Jonas-Gabriel/MercedesC219W211KinematicController/MercedesC219W211KinematicController_Images/ATTiny45-20 Layout.png

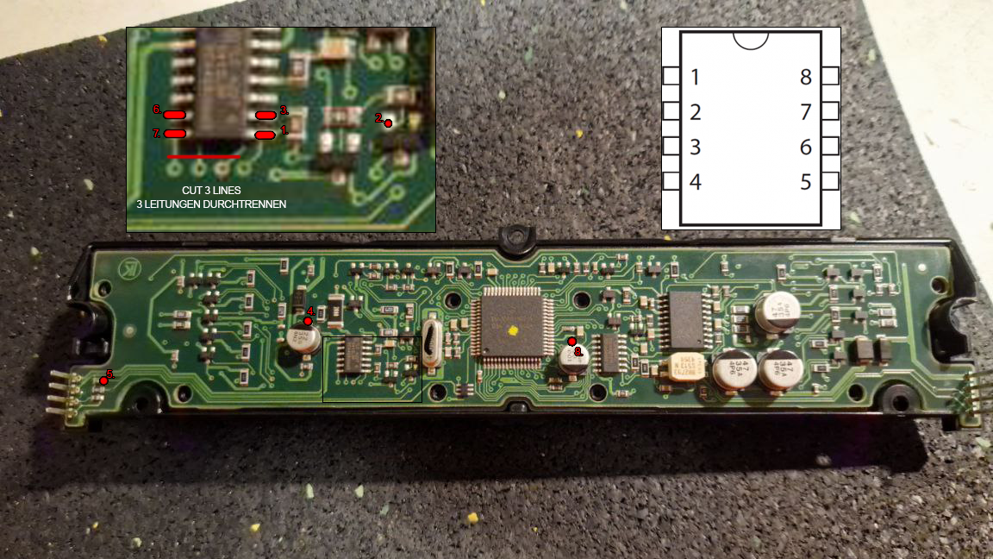
MercedesC219W211KinematicController_Images/ATTiny45-20 Layout.png
