Jonas-Gabriel/MercedesC219W211KinematicController/MercedesC219W211KinematicController_Images/photo_9_2025-12-08_20-57-36.jpg

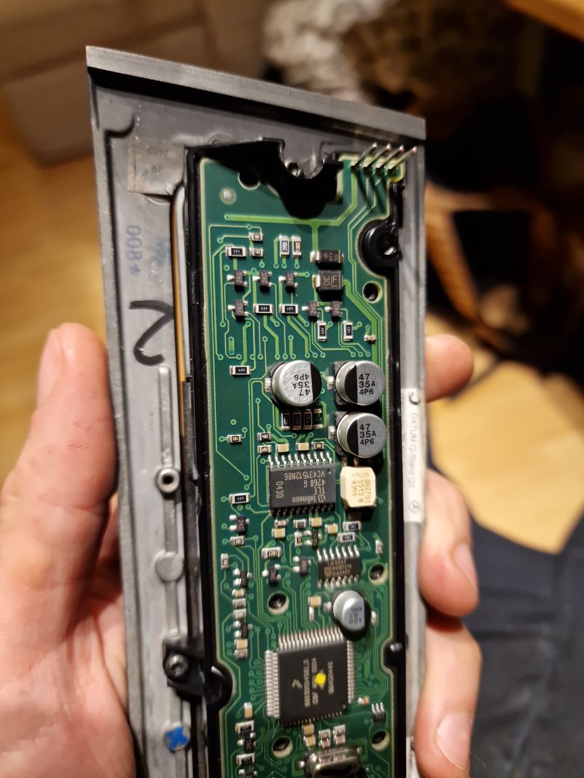
MercedesC219W211KinematicController_Images/photo_9_2025-12-08_20-57-36.jpg
