Jonas-Gabriel/MercedesC219W211KinematicController/(commit log)

2025-12-08 Initial Upload
    If you want to using something different than an Arduino Uno like me (ATTiny45-20), dont forget to change the pins. Maybe adjust also the code.
2025-12-24 little fix to let drive close peroperly...
    stupid but works...
    [MercedesC219W211KinematicController.ino]
